ens-krobot/kbot_2015/pcb_design/propulsion_shield/doc/pinout.pdf

Digital pin 41

Digital pin 40

Digital pin 37

Digital pin 36

Digital pin 35

Digital pin 34

Digital pin 33

Digital pin 32

Digital pin 31

Digital pin 30

VCC

GND

Digital pin 15 (RX3)

Digital pin 14 (TX3)

Digital pin 39

Digital pin 29

Digital pin 28

Digital pin 27

Digital pin 26

Digital pin 25

GND
VCC

Digital pin 22

Digital pin 23

Digital pin 24

VCC

GND

Analog Reference

Analog pin 0
Analog pin 1

Analog pin 2
Analog pin 3

Analog pin 4
Analog pin 5
Analog pin 6
Analog pin 7
Analog pin 8

Analog pin 9

Analog pin 10
Analog pin 11

Analog pin 12

Analog pin 13
Analog pin 14

Analog pin 15

100 | 99 | 98 | 97 | 96 | 95 | 94 | 93 | 92 | 91 | 90 | 89 | 88 | 87 | 86 | 85 | 84 | 83 | 82 | 81 | 80 | 79 | 78 | 77 | 76

1
2 | 74
3 | 73
4 | 72
5
6
7
8 | 68
9 | 67
10 | 66
11
12
13
14 | 62
15 | 61
16 | 60
17
18
19
20 | 56
21 | 55
22 | 54
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
26 | 28 | 29 | 3127 | 30 | 32 | 35 | 36 | 3733 | 34 | 38 | 39 | 40 | 41 | 42 | 43 | 44 | 45 | 46 | 47 | 48 | 49 | 50

GND

Digital pin 4 (PWM) | PG5 (OC0B)
| PE0 (RXD0/PCINT8) PE1 (TXD0)
| PE2 (XCK0/AIN0)
| PE3 (OC3A/AIN1)

PE6 (T3/INT6)

PE5 (OC3C/INT5)

PE4 (OC3B/INT4)

PE7 (CLKO/ICP3/INT7)
VCC
GND
PH0 (RXD2)
PH1 (TXD2)
PH2 (XCK2)
PH3 (OC4A)
PH4 (OC4B)
PH5 (OC4C)
PH6 (OC2B)
PB0 (SS/PCINT0)
PB1 (SCK/PCINT1)
PB2 (MOSI/PCINT2)
PB3 (MISO/PCINT3)
PB4 (OC2A/PCINT4)
PB5 (OC1A/PCINT5)
PB6 (OC1B/PCINT6)

PD4 (ICP1)
PD5 (XCK1)

PD6 (T1)

PD7 (T0)

PG0 (WR)

PG1 (RD)

PC0 (A8)

PC1 (A9)

PC2 (A10)

PC3 (A11)

PC4 (A12)

PC5 (A13)

PC6 (A14)

PC7 (A15)

VCC

PJ0 (RXD3/PCINT9)

PJ1 (TXD3/PCINT10)

PJ2 (XCK3/PCINT11)

PJ3 (PCINT12)

PJ4 (PCINT13)

PJ5 (PCINT14)

PJ6 (PCINT 15)

PG2 (ALE)

PA7 (AD7)

PA6 (AD6)

PA5 (AD5)

PA4 (AD4)

PA3 (AD3)

AVCC
GND

AREF

PF0 (ADC0)
PF1 (ADC1)

PF2 (ADC2)
PF3 (ADC3)

PF4 (ADC4/TMK)

PF5 (ADC5/TMS)

PF6 (ADC6/PCINT14)
PF7 (ADC7/PCINT15)

PK0 (ADC8/PCINT16)
PK1 (ADC9/PCINT17)

PK2 (ADC10/PCINT18)
PK3 (ADC11/PCINT19)

PK4 (ADC12/PCINT20)
PK5 (ADC13/PCINT21)

PK6 (ADC14/PCINT22)
PK7 (ADC15/PCINT23)

GND
VCC
PJ7

PA0 (AD0)

PA1 (AD1)
PA2 (AD2)

Digital pin 0 (RX0)
Digital pin 1 (TX0)

Digital pin 5 (PWM)
Digital pin 2 (PWM)
Digital pin 3 (PWM)

VCC
GND
Digital pin 17 (RX2)
Digital pin 16 (TX2)

Digital pin 6 (PWM)
Digital pin 7 (PWM)
Digital pin 8 (PWM)
Digital pin 9 (PWM)

### USB_TX

### USB_RX

### cod3_A/SCL_HW

### cod3_B/SDA_HW cod2_A

### cod2_B

### cod1_A cod1_B

### SHARP_0

### SHARP_1

### SHARP_2

### SHARP_3

### SHARP_4

### SHARP_5

### EXT_TX EXT_RX

### BT_RX BT_TX

### mot1_en

### mot1_1

### mot1_2

### mot2_1 mot2_2 mot2_en

### mot3_1 mot3_2 mot3_en

ils_0

ils_1

### ils_2

### ils_3

### ils_4

### ils_5

### SPI_MOSI

### SPI_SCK

### SPIMISO

### SPI_SS1

### SPI_SS2 SPI_SS3

### SPI_SS0

### EXT_DET EXT_S1

### EXT_S2

### UI_9

### UI_8

### UI_7

### UI_6

### UI_4

### UI_10 UI_5

### UI_11

### UI_12

### UI_13

UI_0

UI_1

UI_2
UI_3

### reset

PB7 (OC0A/OC1C/PCINT7)

PH7 (T4)
PG3 (TOSC2)

PG4 ( TOSC1 )
RESET

VCC
GND

XTAL2

XTAL1

PL0 (ICP4)
PL1 (ICP5)
PL2 ( T5)

PL3 (OC5A)

PL4 (OC5B)

PL5 (OC5C)
PL6
PL7

PD0 (SCL/INT0)
PD1 (SDA/INT1)

PD2 (RXDI/INT2)
PD3 (TXD1/INT3)

Digital pin 53 (SS)
Digital pin 52 (SCK)
Digital pin 51 (MOSI)
Digital pin 50 (MISO)
Digital pin 10 (PWM)
Digital pin 11 (PWM)
Digital pin 12 (PWM)

Digital pin 13 (PWM)

RESET
VCC

GND

XTAL2

XTAL1
Digital pin 49
Digital pin 48
Digital pin 47

Digital pin 46 (PWM)
Digital pin 45 (PWM)

Digital pin 44 (PWM)
Digital pin 43

Digital pin 42
Digital pin 21 (SCL)

Digital pin 20 (SDA)

Digital pin 19 (RX1)
Digital pin 18 (TX1)

Digital pin 38

### START_BTN

BAT_0 BAT_1

### BAT_2

### LED_ind

### SCL_SW1

### SDA_SW1

### SCL_SW2

### SDA_SW2

### BUZZER
