ens-krobot/kbot_2015/pcb_design/user_interface/PDF/PCB.pdf

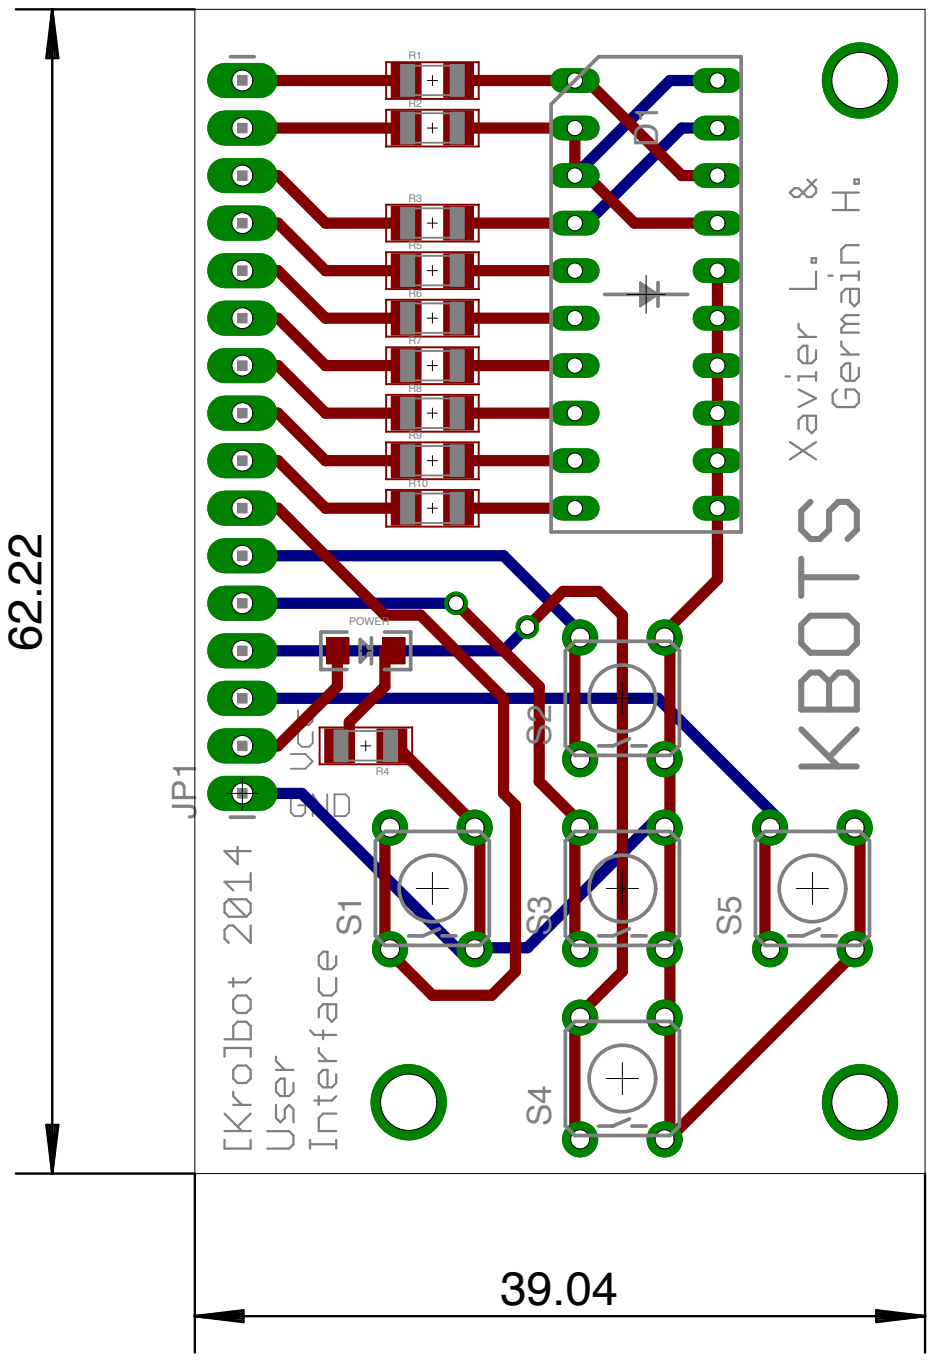
[picture p1: page 1]
