ens-krobot/kbot_2015/pcb_design/user_interface/PDF/Schematics.pdf

1

2

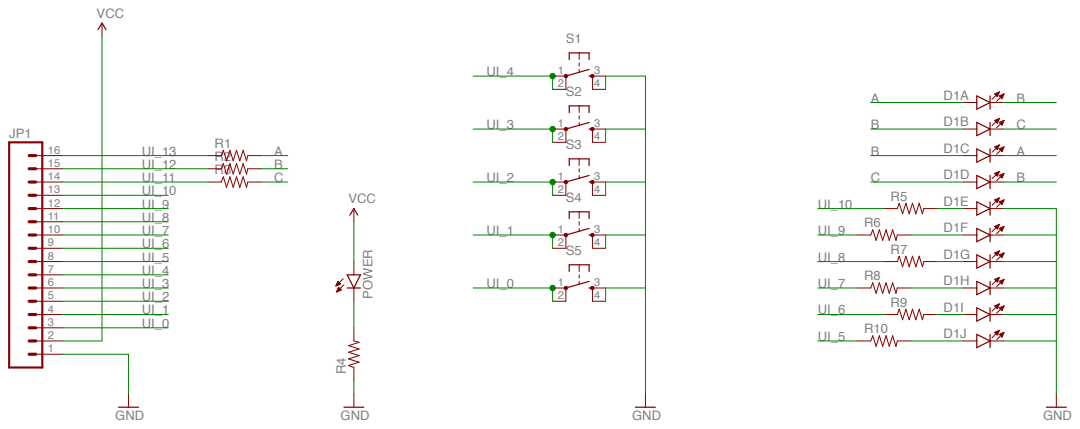
[picture p2: page 1]
