ens-krobot/kbot_2015/pcb_design/propulsion_shield/propulsion_shield.brd

## EAGLE design pcb_design/propulsion_shield/propulsion_shield.brd (2015-10-08)

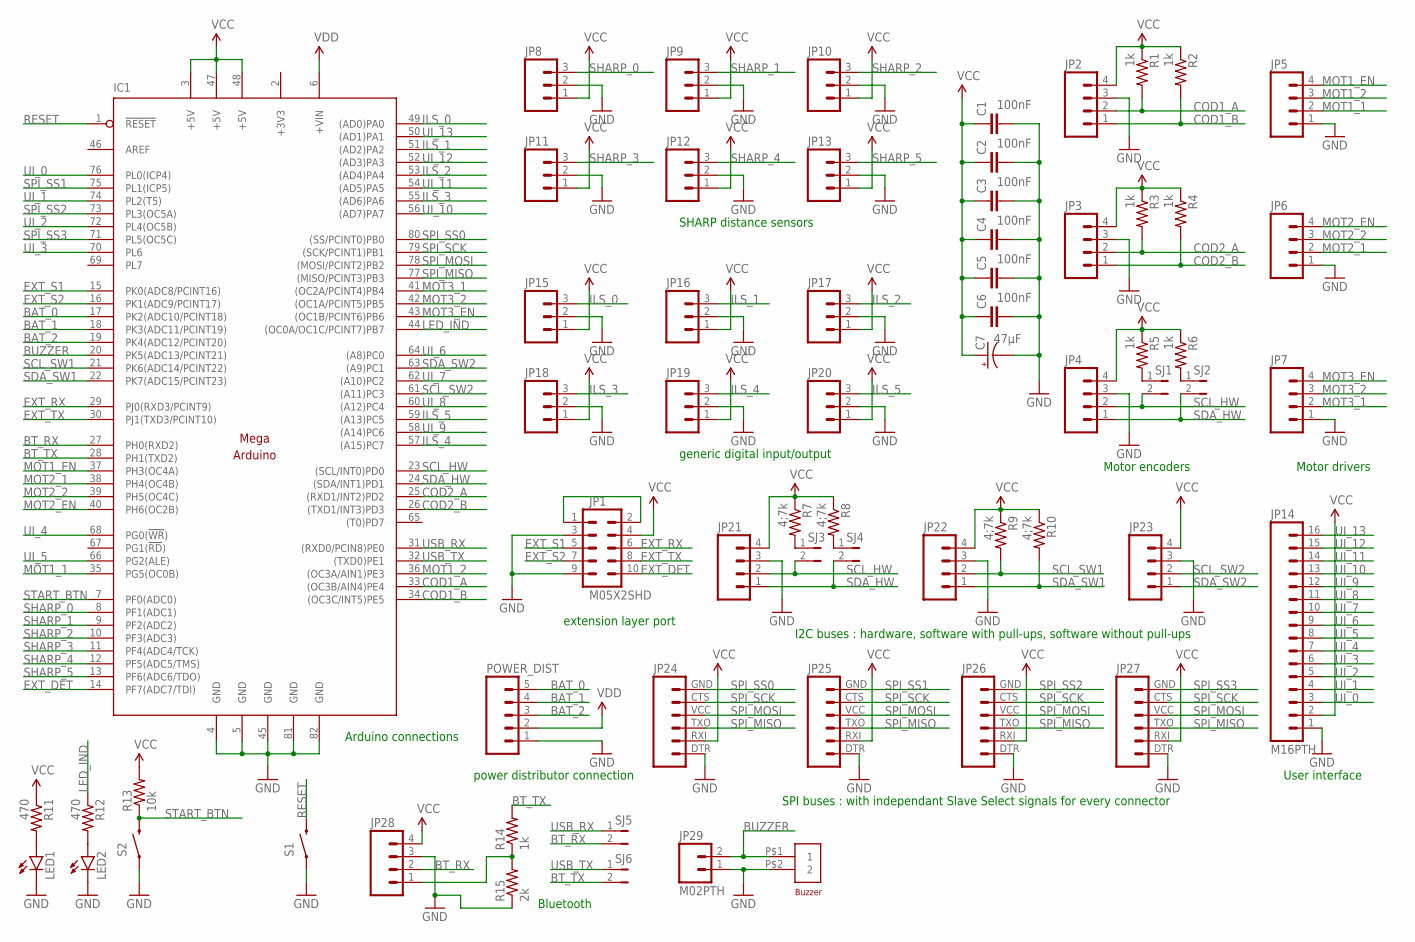
[picture p3: schematic propulsion_shield.sch]

Parts:
C1, C2, C3, C4, C5, C6: 100nF; 1206
C7: 47µF; PANASONIC_D
IC1: MEGAARDUINO_13; MEGA_ARDUINO_NO_HOLE
JP1: M05X2SHD; 2X5-SHROUDED
JP2, JP3, JP4, JP5, JP6, JP7, JP21, JP22, JP23, JP28: M04PTH; 1X04
JP8, JP9, JP10, JP11, JP12, JP13, JP15, JP16, JP17, JP18, JP19, JP20: M03PTH; 1X03
JP14: M16PTH; 1X16
JP24, JP25, JP26, JP27: M06SIP; 1X06
JP29: M02PTH; 1X02
LED1, LED2: LED1206; LED-1206
POWER_DIST: M05PTH; 1X05
R1, R2, R3, R4, R5, R6, R14: 1k; 1206
R7, R8, R9, R10: 4;7k; 1206
R11, R12: 470; 1206
R13: 10k; 1206
R15: 2k; 1206
S1, S2: SWITCH-MOMENTARY-2PTH; TACTILE-PTH
SJ1, SJ2, SJ3, SJ4, SJ5, SJ6: JUMPER-PTH-2-NO; PTH-JUMPER-2-NO_NO_SILK
U$1: BUZZER

Connections:
+3V3: IC1.2 (+3V3)
BAT_0: IC1.17 (PK2(ADC10/PCINT18)), POWER_DIST.5
BAT_1: IC1.18 (PK3(ADC11/PCINT19)), POWER_DIST.4
BAT_2: IC1.19 (PK4(ADC12/PCINT20)), POWER_DIST.3
BT_RX: IC1.27 (PH0(RXD2)), JP28.2, SJ5.2
BT_TX: IC1.28 (PH1(TXD2)), R14.2, SJ6.2
BUZZER: IC1.20 (PK5(ADC13/PCINT21)), JP29.2, U$1.P$1 (1)
COD1_A: IC1.33 ((OC3B/AIN4)PE4), JP2.2, R1.2
COD1_B: IC1.34 ((OC3C/INT5)PE5), JP2.1, R2.2
COD2_A: IC1.25 ((RXD1/INT2)PD2), JP3.2, R3.2
COD2_B: IC1.26 ((TXD1/INT3)PD3), JP3.1, R4.2
EXT_DET: IC1.14 (PF7(ADC7/TDI)), JP1.10
EXT_RX: IC1.29 (PJ0(RXD3/PCINT9)), JP1.6
EXT_S1: IC1.15 (PK0(ADC8/PCINT16)), JP1.5
EXT_S2: IC1.16 (PK1(ADC9/PCINT17)), JP1.7
EXT_TX: IC1.30 (PJ1(TXD3/PCINT10)), JP1.8
GND: C1.2, C2.2, C3.2, C4.2, C5.2, C6.2, C7.-, IC1.4 (GND), IC1.5 (GND), IC1.45 (GND), IC1.81 (GND), IC1.82 (GND), JP1.3, JP1.9, JP2.3, JP3.3, JP4.3, JP5.1, JP6.1, JP7.1, JP8.2, JP9.2, JP10.2, JP11.2, JP12.2, JP13.2, JP14.1, JP15.2, JP16.2, JP17.2, JP18.2, JP19.2, JP20.2, JP21.3, JP22.3, JP23.3, JP24.DTR (1), JP25.DTR (1), JP26.DTR (1), JP27.DTR (1), JP28.3, JP29.1, LED1.C, LED2.C, POWER_DIST.1, R15.1, S1.1, S2.1, U$1.P$2 (2)
ILS_0: IC1.49 ((AD0)PA0), JP15.3
ILS_1: IC1.51 ((AD2)PA2), JP16.3
ILS_2: IC1.53 ((AD4)PA4), JP17.3
ILS_3: IC1.55 ((AD6)PA6), JP18.3
ILS_4: IC1.57 ((A15)PC7), JP19.3
ILS_5: IC1.59 ((A13)PC5), JP20.3
LED_IND: IC1.44 ((OC0A/OC1C/PCINT7)PB7), R12.1
MOT1_1: IC1.35 (PG5(OC0B)), JP5.2
MOT1_2: IC1.36 ((OC3A/AIN1)PE3), JP5.3
MOT1_EN: IC1.37 (PH3(OC4A)), JP5.4
MOT2_1: IC1.38 (PH4(OC4B)), JP6.2
MOT2_2: IC1.39 (PH5(OC4C)), JP6.3
MOT2_EN: IC1.40 (PH6(OC2B)), JP6.4
MOT3_1: IC1.41 ((OC2A/PCINT4)PB4), JP7.2
MOT3_2: IC1.42 ((OC1A/PCINT5)PB5), JP7.3
MOT3_EN: IC1.43 ((OC1B/PCINT6)PB6), JP7.4
unnamed: JP1.1, JP1.2
unnamed: R7.2, SJ3.1
unnamed: R8.2, SJ4.1
unnamed: R5.2, SJ1.1
unnamed: R6.2, SJ2.1
unnamed: LED1.A, R11.2
unnamed: LED2.A, R12.2
unnamed: JP28.1, R14.1, R15.2
RESET: IC1.1 (!RESET), S1.3 (2)
SCL_HW: IC1.23 ((SCL/INT0)PD0), JP4.2, JP21.2, SJ1.2, SJ3.2
SCL_SW1: IC1.21 (PK6(ADC14/PCINT22)), JP22.2, R9.2
SCL_SW2: IC1.61 ((A11)PC3), JP23.2
SDA_HW: IC1.24 ((SDA/INT1)PD1), JP4.1, JP21.1, SJ2.2, SJ4.2
SDA_SW1: IC1.22 (PK7(ADC15/PCINT23)), JP22.1, R10.2
SDA_SW2: IC1.63 ((A9)PC1), JP23.1
SHARP_0: IC1.8 (PF1(ADC1)), JP8.3
SHARP_1: IC1.9 (PF2(ADC2)), JP9.3
SHARP_2: IC1.10 (PF3(ADC3)), JP10.3
SHARP_3: IC1.11 (PF4(ADC4/TCK)), JP11.3
SHARP_4: IC1.12 (PF5(ADC5/TMS)), JP12.3
SHARP_5: IC1.13 (PF6(ADC6/TDO)), JP13.3
SPI_MISO: IC1.77 ((MISO/PCINT3)PB3), JP24.TXO (3), JP25.TXO (3), JP26.TXO (3), JP27.TXO (3)
SPI_MOSI: IC1.78 ((MOSI/PCINT2)PB2), JP24.VCC (4), JP25.VCC (4), JP26.VCC (4), JP27.VCC (4)
SPI_SCK: IC1.79 ((SCK/PCINT1)PB1), JP24.CTS (5), JP25.CTS (5), JP26.CTS (5), JP27.CTS (5)
SPI_SS0: IC1.80 ((SS/PCINT0)PB0), JP24.GND (6)
SPI_SS1: IC1.75 (PL1(ICP5)), JP25.GND (6)
SPI_SS2: IC1.73 (PL3(OC5A)), JP26.GND (6)
SPI_SS3: IC1.71 (PL5(OC5C)), JP27.GND (6)
START_BTN: IC1.7 (PF0(ADC0)), R13.1, S2.3 (2)
UI_0: IC1.76 (PL0(ICP4)), JP14.3
UI_1: IC1.74 (PL2(T5)), JP14.4
UI_2: IC1.72 (PL4(OC5B)), JP14.5
UI_3: IC1.70 (PL6), JP14.6
UI_4: IC1.68 (PG0(!WR!)), JP14.7
UI_5: IC1.66 (PG2(ALE)), JP14.8
UI_6: IC1.64 ((A8)PC0), JP14.9
UI_7: IC1.62 ((A10)PC2), JP14.10
UI_8: IC1.60 ((A12)PC4), JP14.11
UI_9: IC1.58 ((A14)PC6), JP14.12
UI_10: IC1.56 ((AD7)PA7), JP14.13
UI_11: IC1.54 ((AD5)PA5), JP14.14
UI_12: IC1.52 ((AD3)PA3), JP14.15
UI_13: IC1.50 ((AD1)PA1), JP14.16
USB_RX: IC1.31 ((RXD0/PCIN8)PE0), SJ5.1
USB_TX: IC1.32 ((TXD0)PE1), SJ6.1
VCC: C1.1, C2.1, C3.1, C4.1, C5.1, C6.1, C7.+, IC1.3 (+5V), IC1.47 (+5V), IC1.48 (+5V), JP1.4, JP2.4, JP3.4, JP4.4, JP8.1, JP9.1, JP10.1, JP11.1, JP12.1, JP13.1, JP14.2, JP15.1, JP16.1, JP17.1, JP18.1, JP19.1, JP20.1, JP21.4, JP22.4, JP23.4, JP24.RXI (2), JP25.RXI (2), JP26.RXI (2), JP27.RXI (2), JP28.4, R1.1, R2.1, R3.1, R4.1, R5.1, R6.1, R7.1, R8.1, R9.1, R10.1, R11.1, R13.2
VDD: IC1.6 (+VIN), POWER_DIST.2

Notes on the sheet:
power distributor connection
extension layer port
Arduino connections
Motor encoders
Motor drivers
User interface
SHARP distance sensors
generic digital input/output
I2C buses : hardware, software with pull-ups, software without pull-ups
SPI buses : with independant Slave Select signals for every connector
Bluetooth

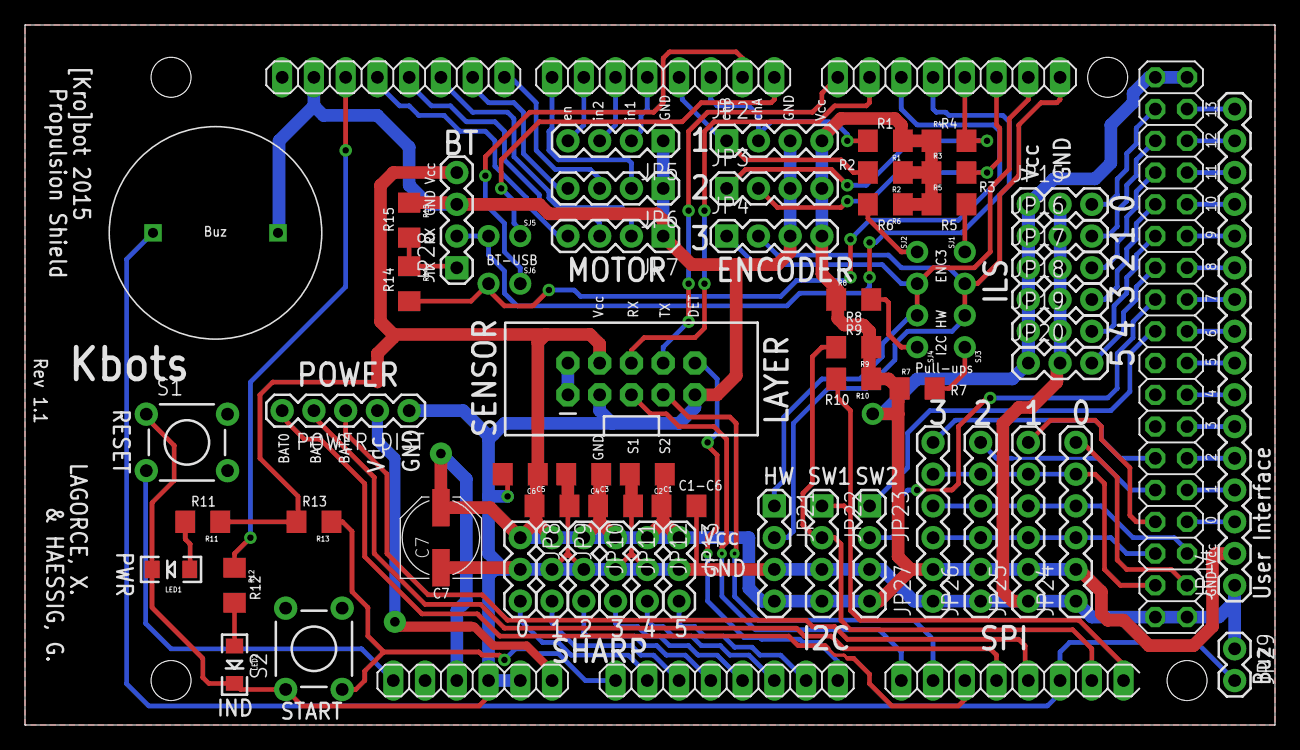
[picture p4: board propulsion_shield.brd from above]

Board: 2 copper layers, 100.0 x 56.0 mm, 64 parts (0 on the bottom side), 79 nets.
