ens-krobot/kbot_2015/pcb_design/user_interface/Krobot_UI.brd

## EAGLE design pcb_design/user_interface/Krobot_UI.brd (2015-10-08)

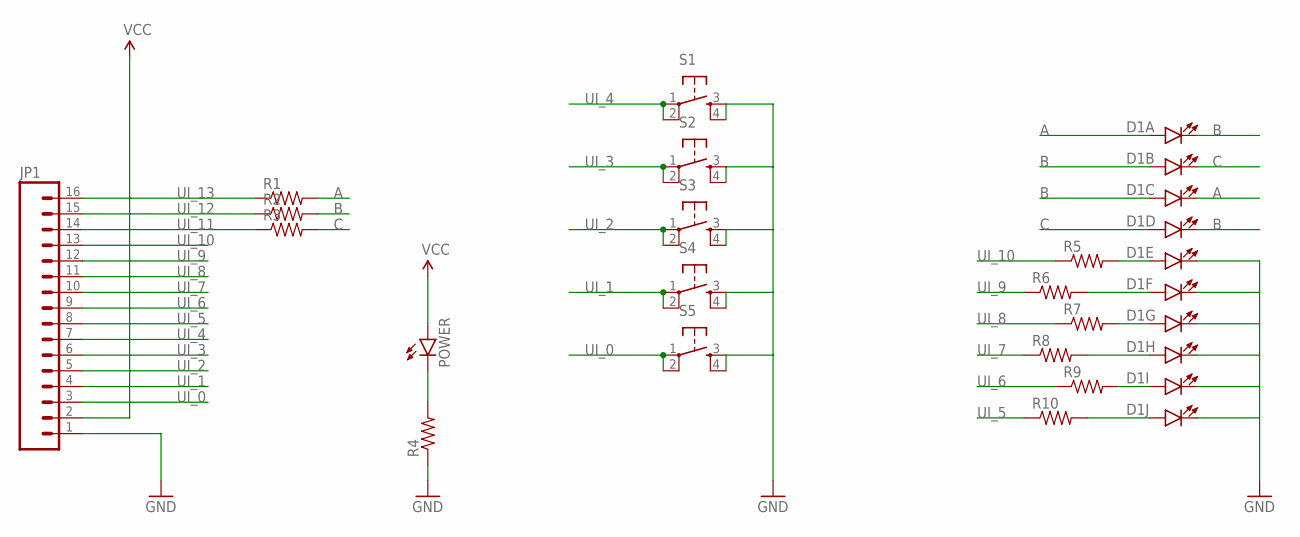
[picture p5: schematic Krobot_UI.sch, h kjjkb]

Parts:
D1: LED_BARGRAPH_10; LED_BARGAPH_10
JP1: 1X16_LONGPADS
POWER: LED1206; LED-1206
R1, R2, R3, R4, R5, R6, R7, R8, R9, R10: RESISTOR1206; 1206
S1, S2, S3, S4, S5: TAC_SWITCHPTH; TACTILE-PTH

Connections:
A: D1.1 (A), D1.18 (C), R1.2
B: D1.2 (A), D1.3 (A), D1.17 (C), D1.20 (C), R2.2
C: D1.4 (A), D1.19 (C), R3.2
GND: D1.11 (C), D1.12 (C), D1.13 (C), D1.14 (C), D1.15 (C), D1.16 (C), JP1.1, R4.1, S1.3, S1.4, S2.3, S2.4, S3.3, S3.4, S4.3, S4.4, S5.3, S5.4
unnamed: D1.5 (A), R5.2
unnamed: D1.6 (A), R6.2
unnamed: D1.7 (A), R7.2
unnamed: D1.8 (A), R8.2
unnamed: D1.9 (A), R9.2
unnamed: D1.10 (A), R10.2
unnamed: POWER.C, R4.2
UI_0: JP1.3, S5.1, S5.2
UI_1: JP1.4, S4.1, S4.2
UI_2: JP1.5, S3.1, S3.2
UI_3: JP1.6, S2.1, S2.2
UI_4: JP1.7, S1.1, S1.2
UI_5: JP1.8, R10.1
UI_6: JP1.9, R9.1
UI_7: JP1.10, R8.1
UI_8: JP1.11, R7.1
UI_9: JP1.12, R6.1
UI_10: JP1.13, R5.1
UI_11: JP1.14, R3.1
UI_12: JP1.15, R2.1
UI_13: JP1.16, R1.1
VCC: JP1.2, POWER.A

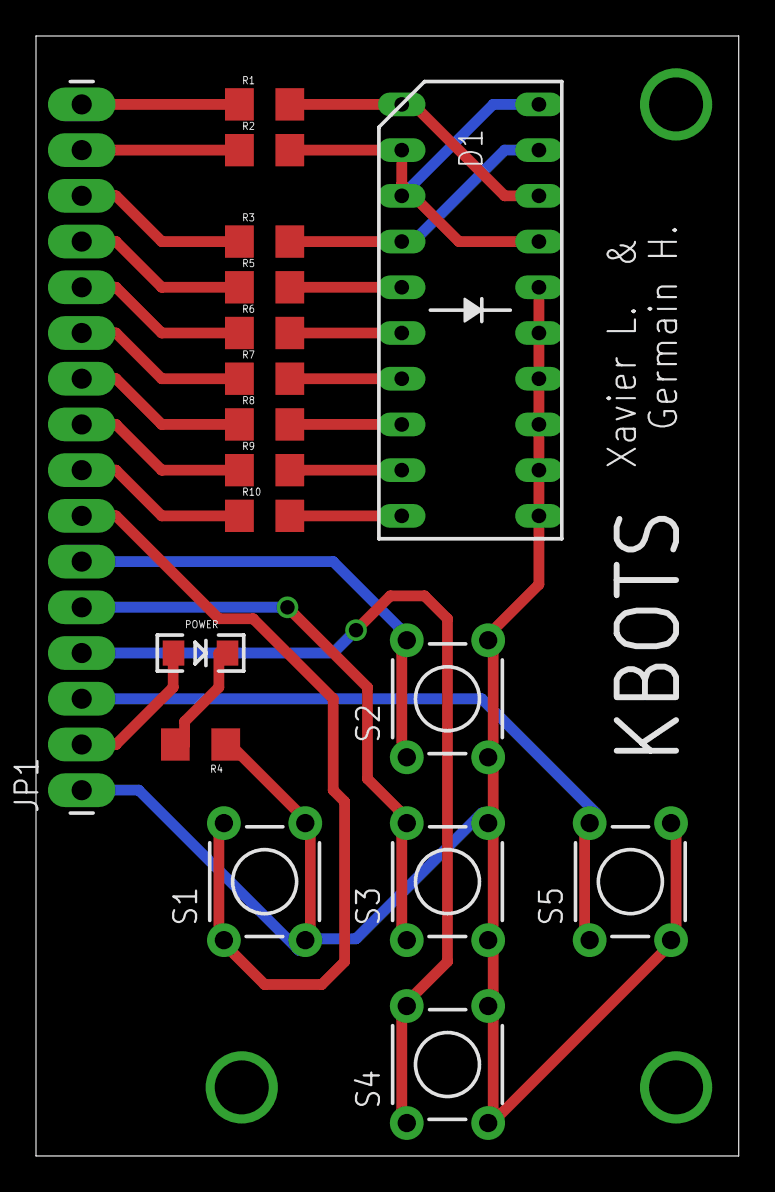
[picture p6: board Krobot_UI.brd from above]

Board: 2 copper layers, 39.0 x 62.2 mm, 18 parts (0 on the bottom side), 26 nets.
