ens-krobot/kbot_2015/pcb_design/power_distributor/power_distributor.brd

## EAGLE design pcb_design/power_distributor/power_distributor.brd (2015-10-08)

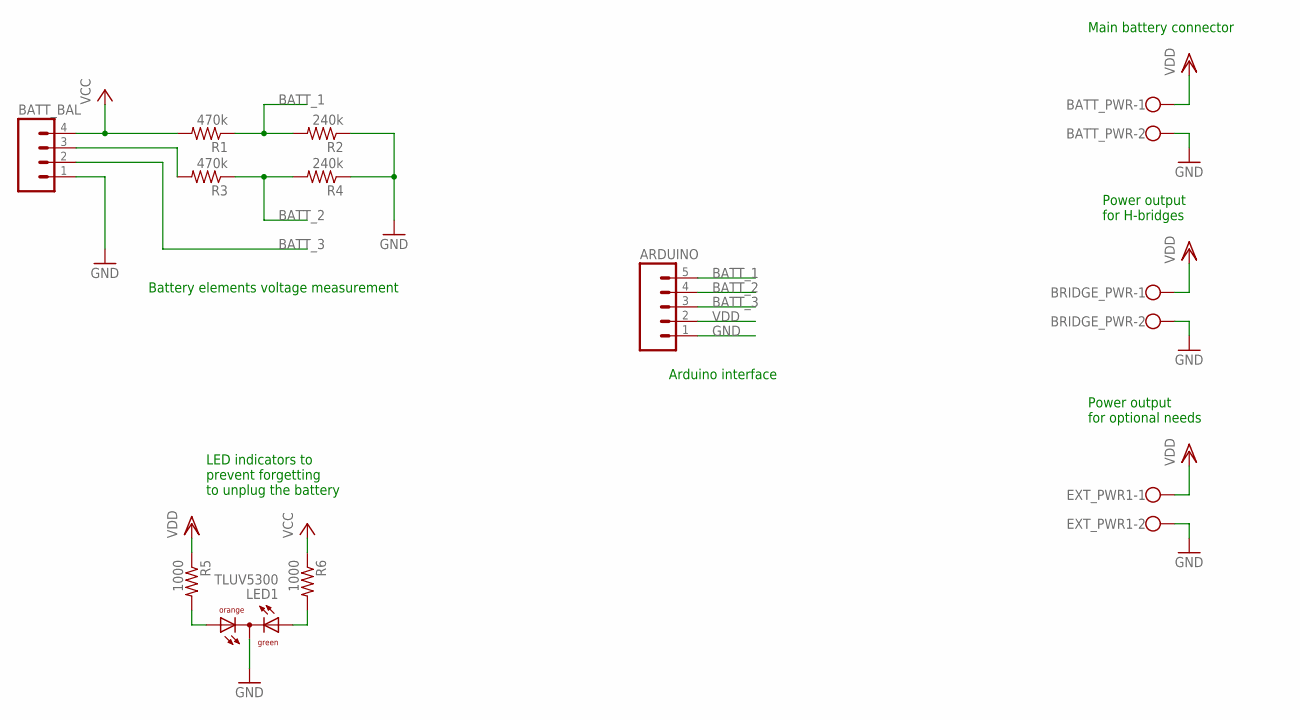
[picture p7: schematic power_distributor.sch]

Parts:
ARDUINO: M05PTH; 1X05
BATT_BAL: M04POLAR; MOLEX-1X4
BATT_PWR: W237-102
BRIDGE_PWR: W237-102
EXT_PWR1: W237-102
LED1: TLUV5300
R1, R3: 470k; 1206
R2, R4: 240k; 1206
R5, R6: 1000; 1206

Connections:
BATT_1: ARDUINO.5, R1.1, R2.2
BATT_2: ARDUINO.4, R3.1, R4.2
BATT_3: ARDUINO.3, BATT_BAL.2
GND: ARDUINO.1, BATT_BAL.1, BATT_PWR.2, BRIDGE_PWR.2, EXT_PWR1.2, LED1.CC, R2.1, R4.1
unnamed: LED1.AO, R5.2
unnamed: BATT_BAL.3, R3.2
unnamed: LED1.AG, R6.2
VCC: BATT_BAL.4, R1.2, R6.1
VDD: ARDUINO.2, BATT_PWR.1, BRIDGE_PWR.1, EXT_PWR1.1, R5.1

Notes on the sheet:
Main battery connector
LED indicators to prevent forgetting to unplug the battery
Power output for H-bridges
Power output for optional needs
Arduino interface
Battery elements voltage measurement

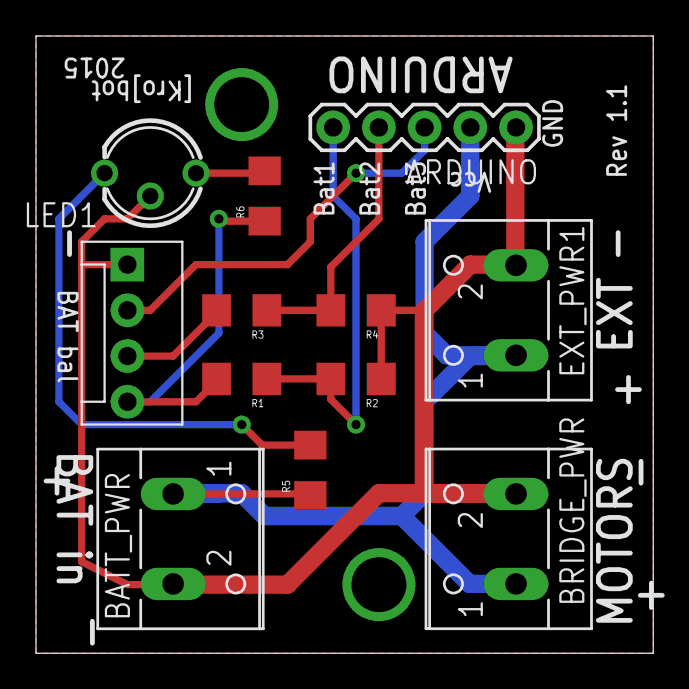
[picture p8: board power_distributor.brd from above]

Board: 2 copper layers, 34.3 x 34.3 mm, 12 parts (0 on the bottom side), 9 nets.
