ens-krobot/kbot_2015/(commit log)

2014-10-03 [pcb_design] Added some support files
    * Arduino PCB library
    * DRU file for electrodragon
2014-10-03 [pcb_design] Initial import of the power distributor board
    [power_distributor.brd, power_distributor.sch]
2014-10-07 [support_files] Added new footprint for arduino mega and make git ignore library editing temp files
2014-10-07 [propulsion_shield] Added schematics and "empty" board for propulsion shield
    [propulsion_shield.brd, propulsion_shield.sch]
2014-10-07 [propulsion_shield] First draft of components placement + Bugfixes in schematics
    [propulsion_shield.brd, propulsion_shield.sch]
2014-10-08 [propulsion_shield] Full routing of the PCB
    [propulsion_shield.brd, propulsion_shield.sch]
2014-10-08 [propulsion_shield] Updated pinout documentation according to last version of schematics
2014-10-08 [propulsion_shield] Added Silkscreen on board
    [propulsion_shield.brd, propulsion_shield.sch]
2014-10-09 [propulsion_shield] Added a buzzer on the board
    [propulsion_shield.brd, propulsion_shield.sch]
2014-10-27 [user_interface] Add user_interface board design
    [Krobot_UI.brd, Krobot_UI.sch]
2015-02-11 [code] Adapted Odometry and Propulsion classes to allow omnidirectional robots
2015-05-12 [SpeedProfiler] Added member function de stop the robot with a given acceleration
2015-05-12 [libraries] Added liquidcrystal library with support for software I2C
2015-10-07 [PCB/propulsion_shield] Correction routing of power supply to Vin arduino pin (schematics + PCB)
    [propulsion_shield.brd, propulsion_shield.sch]
2015-10-08 [PCB/power_distributor] Correcting wrong JST footprint
    [power_distributor.brd, power_distributor.sch]
2015-10-08 [PCB/krobot_ui] Change date on silkscreen
    [Krobot_UI.brd]
2015-10-08 [PCB/propulsion_shield] Change date and version number
    [propulsion_shield.brd, propulsion_shield.sch]
